adi-wayn/animatromic-head/docs/Animatronic Skull - 2456550/images/6c71d4edd238dc1699e310051e960971.png

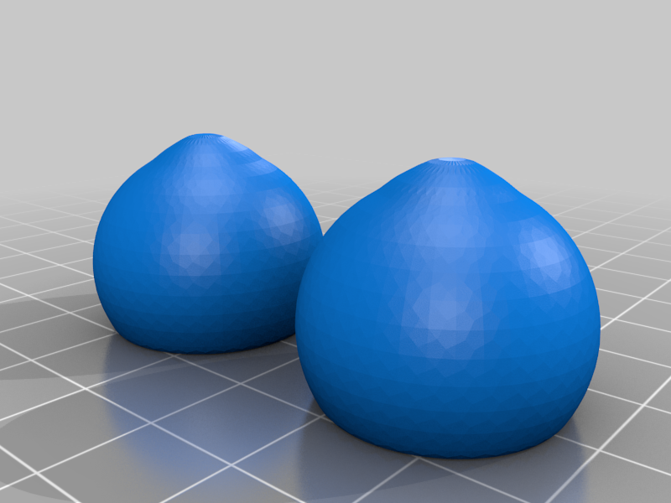
docs/Animatronic Skull - 2456550/images/6c71d4edd238dc1699e310051e960971.png
