adi-wayn/animatromic-head/docs/Animatronic Skull - 2456550/images/8e597aa7ed4feb77dbbf5bba94c87eed.png

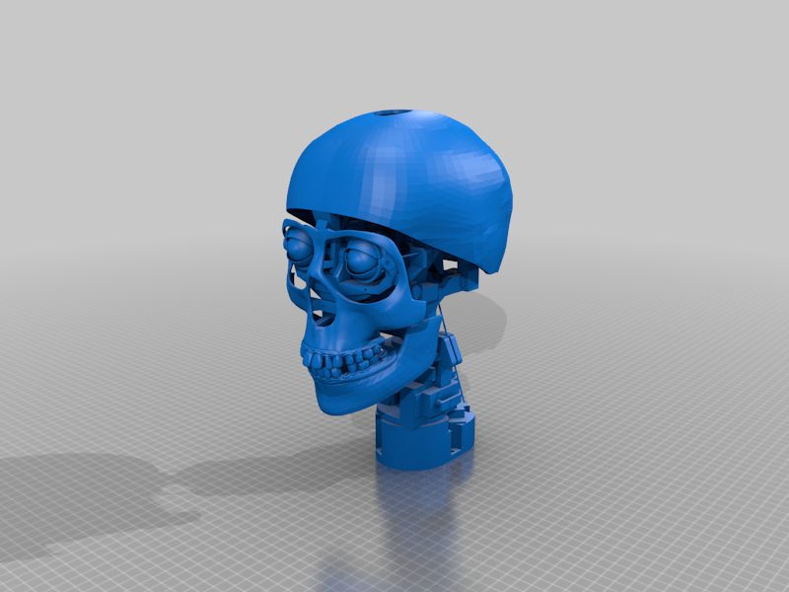
docs/Animatronic Skull - 2456550/images/8e597aa7ed4feb77dbbf5bba94c87eed.png
