adi-wayn/animatromic-head/docs/Animatronic Skull - 2456550/images/57f312213586f4db5ce062b65d8a6737.png

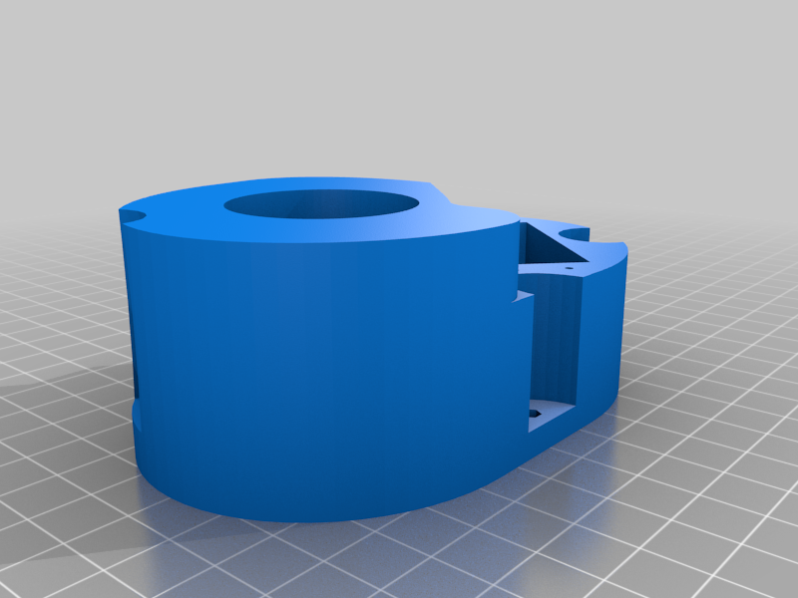
docs/Animatronic Skull - 2456550/images/57f312213586f4db5ce062b65d8a6737.png
