adi-wayn/animatromic-head/docs/Animatronic Skull - 2456550/images/98adeaafc3d5930cc63d995662715cfa.png

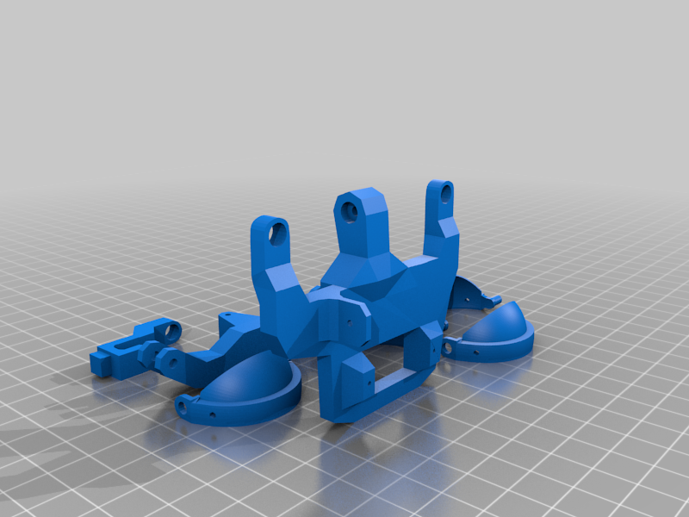
docs/Animatronic Skull - 2456550/images/98adeaafc3d5930cc63d995662715cfa.png
