adi-wayn/animatromic-head/docs/Animatronic Skull - 2456550/images/769c73fbf3607413a82ab738395b322f.png

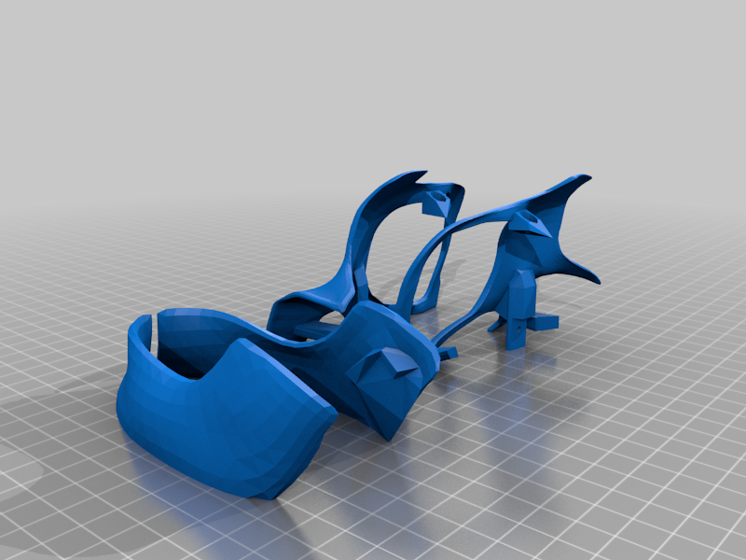
docs/Animatronic Skull - 2456550/images/769c73fbf3607413a82ab738395b322f.png
