adi-wayn/animatromic-head/docs/Animatronic Skull - 2456550/images/7205a307fcd111a9c5d29df97c076238.png

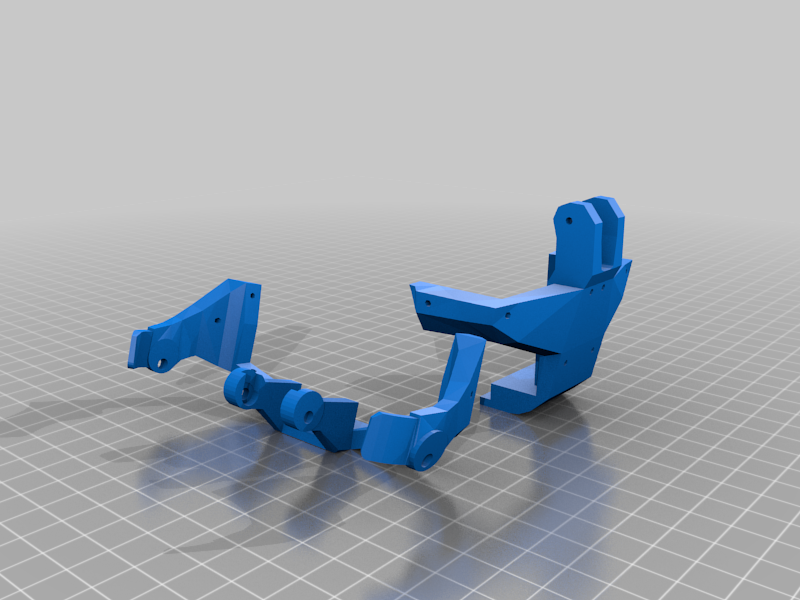
docs/Animatronic Skull - 2456550/images/7205a307fcd111a9c5d29df97c076238.png
