adi-wayn/animatromic-head/docs/Animatronic Skull - 2456550/images/20170731_230624.jpg

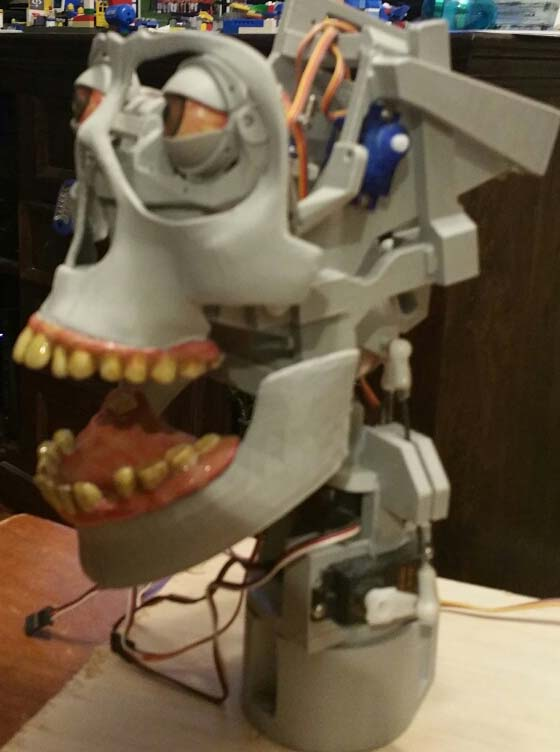
docs/Animatronic Skull - 2456550/images/20170731_230624.jpg
