adi-wayn/animatromic-head/docs/Animatronic Skull - 2456550/images/20170731_230637.jpg

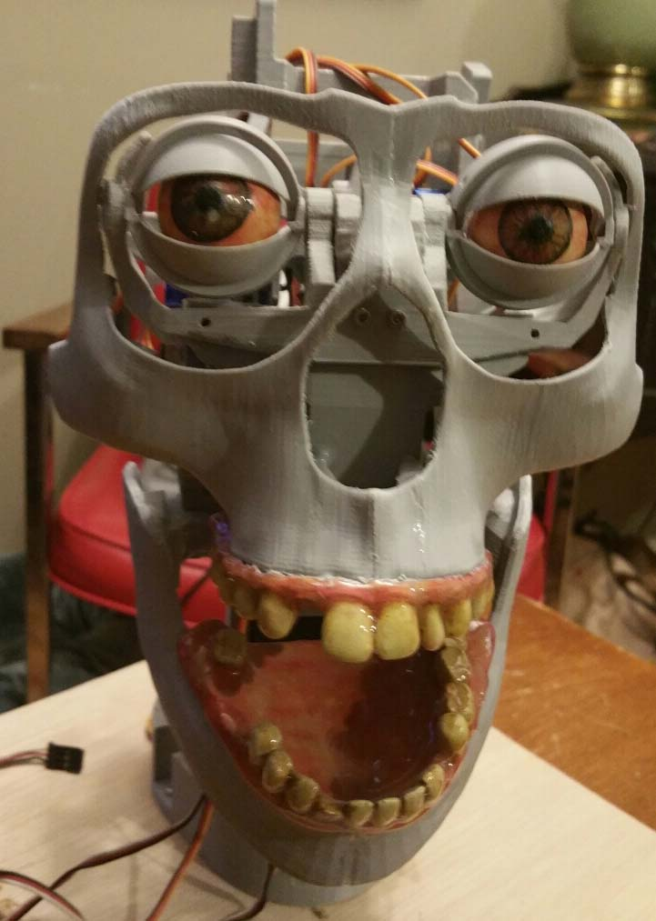
docs/Animatronic Skull - 2456550/images/20170731_230637.jpg
