adi-wayn/animatromic-head/docs/Animatronic Skull - 2456550/images/914772802240a5b13014ea125088135e.png

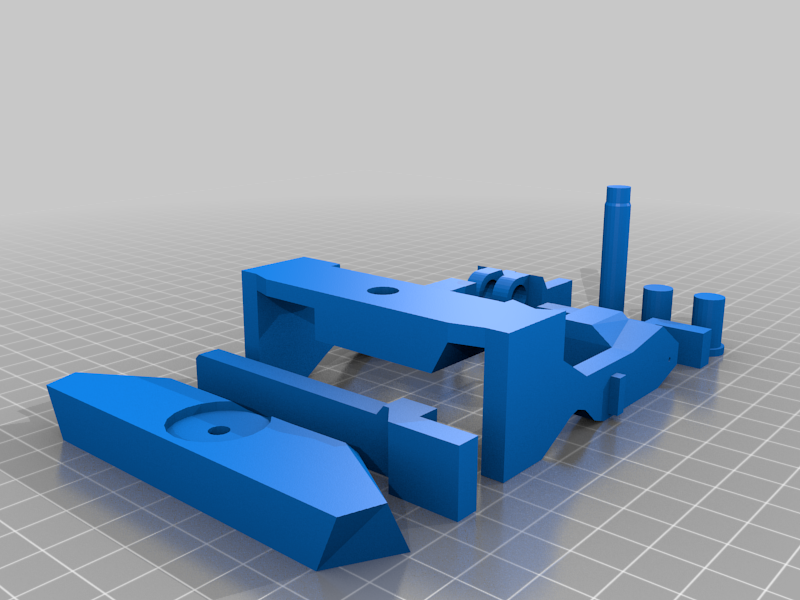
docs/Animatronic Skull - 2456550/images/914772802240a5b13014ea125088135e.png
