adi-wayn/animatromic-head/docs/Animatronic Skull - 2456550/images/a1fdf8aa04cd3241627027f55734ce39.png

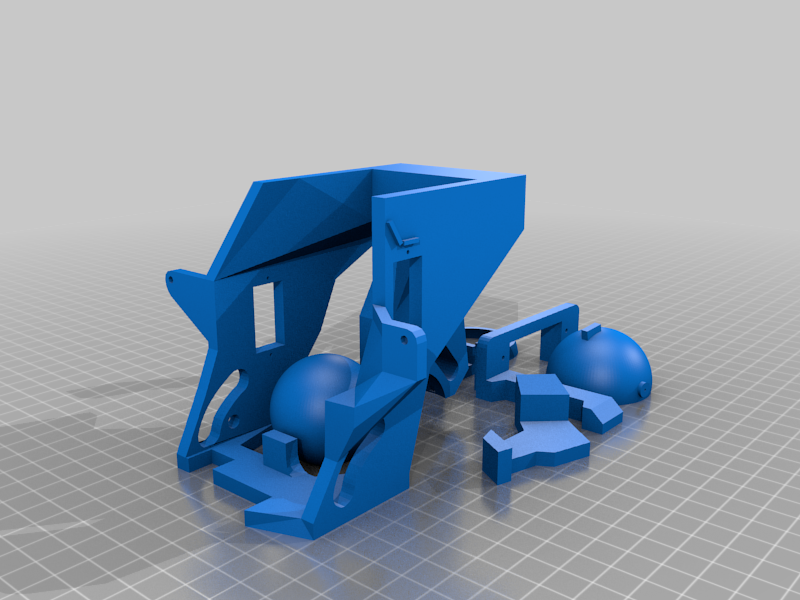
docs/Animatronic Skull - 2456550/images/a1fdf8aa04cd3241627027f55734ce39.png
