adi-wayn/animatromic-head/docs/Animatronic Skull - 2456550/images/a887fb557152063ed58c4bb3162da280.png

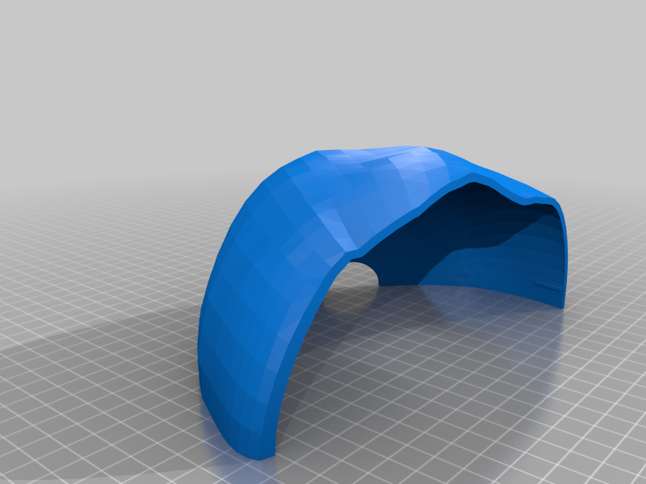
docs/Animatronic Skull - 2456550/images/a887fb557152063ed58c4bb3162da280.png
