adi-wayn/animatromic-head/docs/Animatronic Skull - 2456550/images/c83e7a57c6ebd02146b7218c535b35e5.png

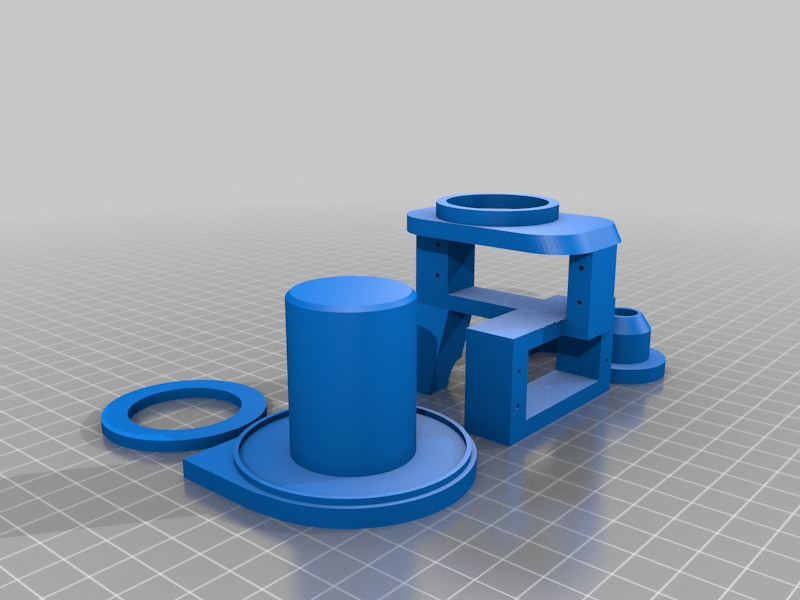
docs/Animatronic Skull - 2456550/images/c83e7a57c6ebd02146b7218c535b35e5.png
