adi-wayn/animatromic-head/docs/Animatronic Skull - 2456550/images/f0b370f981ca99bb3add569225a746b9.png

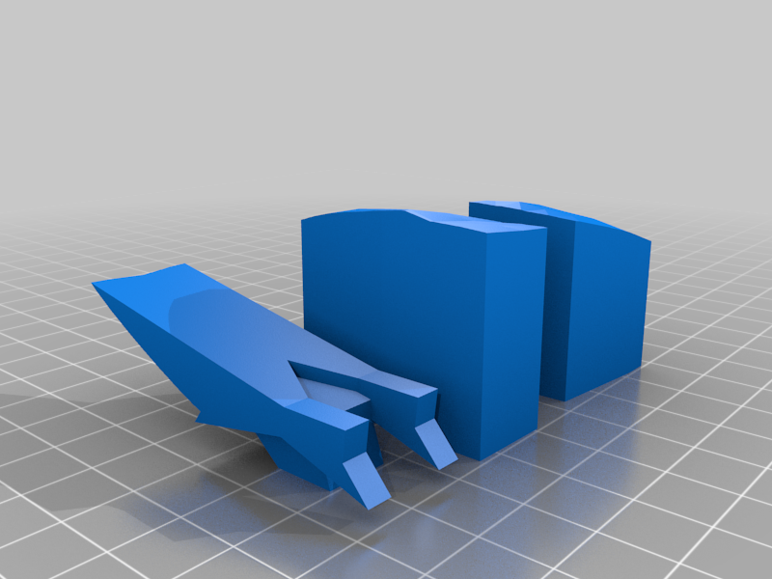
docs/Animatronic Skull - 2456550/images/f0b370f981ca99bb3add569225a746b9.png
