adi-wayn/animatromic-head/docs/Animatronic Skull - 2456550/images/f6bd3e2ded30b17894b5889a3ba40300.png

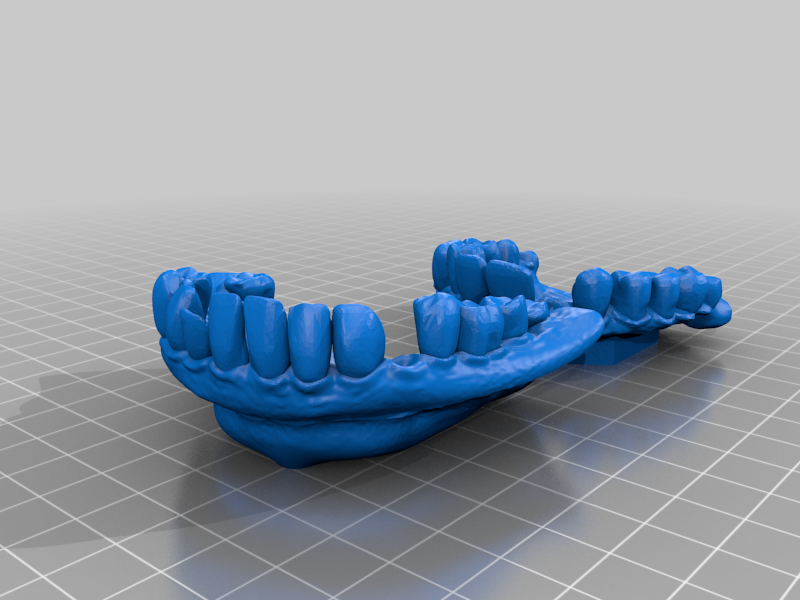
docs/Animatronic Skull - 2456550/images/f6bd3e2ded30b17894b5889a3ba40300.png
