adi-wayn/animatromic-head/docs/Animatronic Skull - 2456550/images/f53a53cf6e166b89eecce7e33b7ac451.png

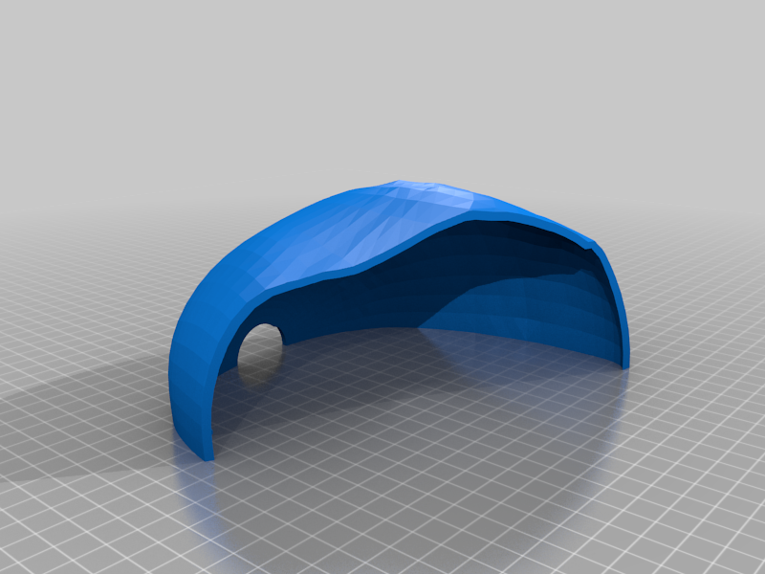
docs/Animatronic Skull - 2456550/images/f53a53cf6e166b89eecce7e33b7ac451.png
