adi-wayn/animatromic-head/host/simulator/screenshot.png

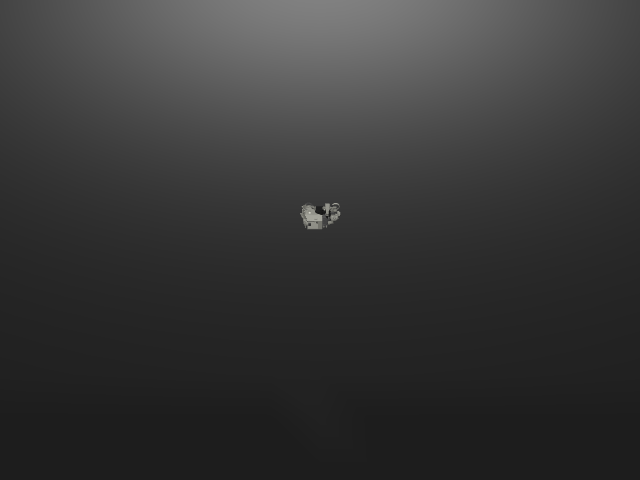
host/simulator/screenshot.png
