adi-wayn/animatromic-head/host/simulator/screenshot_0.png

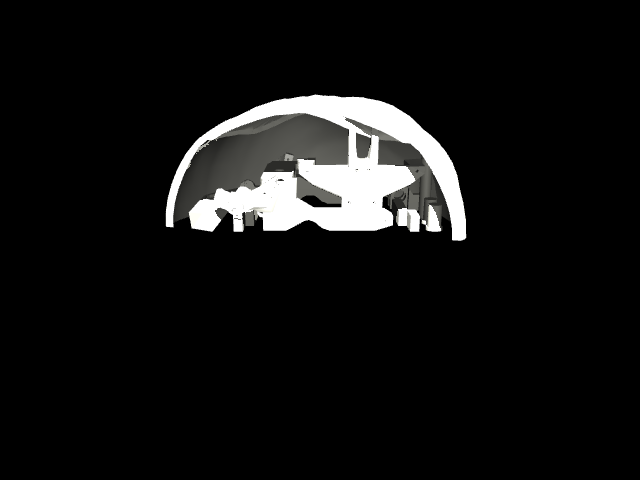
host/simulator/screenshot_0.png
