adi-wayn/animatromic-head/host/simulator/screenshot_1.png

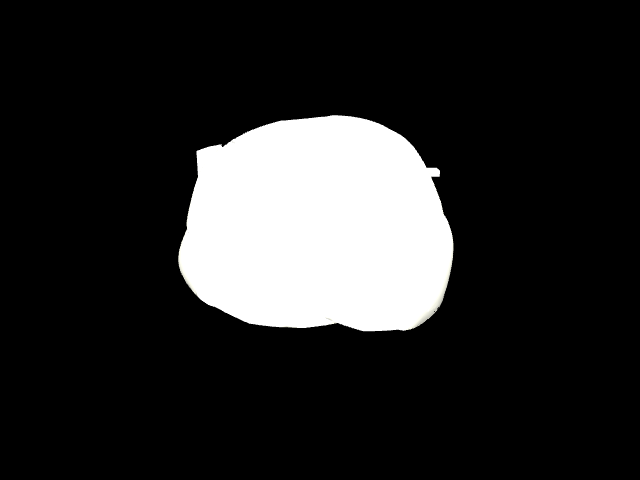
host/simulator/screenshot_1.png
