adi-wayn/animatromic-head/host/simulator/screenshot_2.png

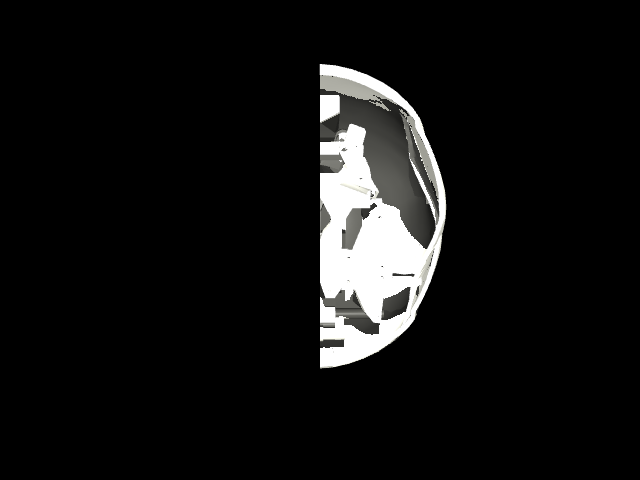
host/simulator/screenshot_2.png
