adi-wayn/animatromic-head/host/simulator/screenshot_3.png

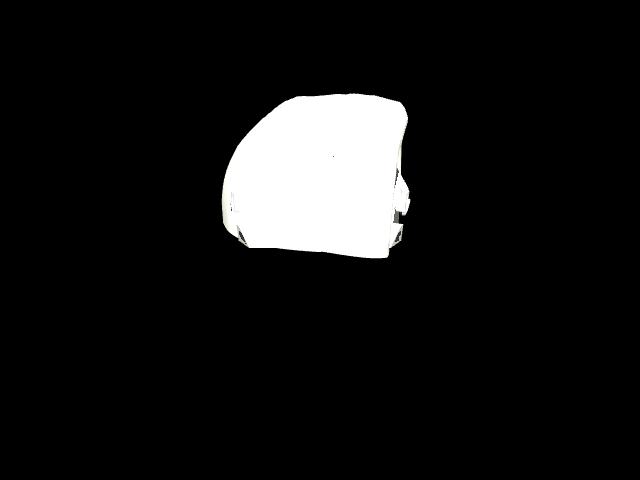
host/simulator/screenshot_3.png
