adi-wayn/animatromic-head/host/simulator/screenshot_4.png

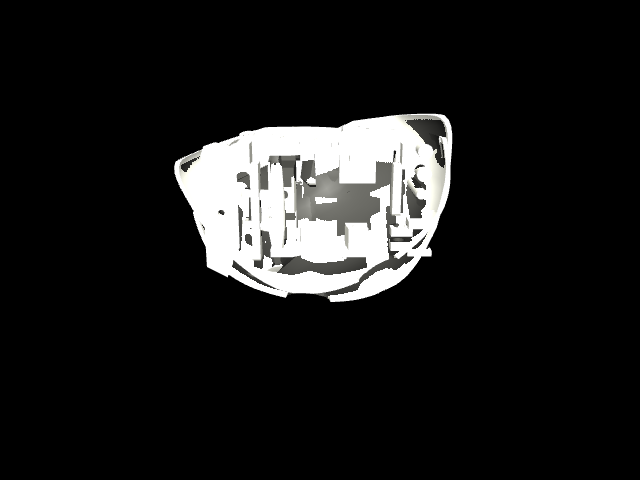
host/simulator/screenshot_4.png
