adi-wayn/animatromic-head/host/simulator/skull_screenshot.png

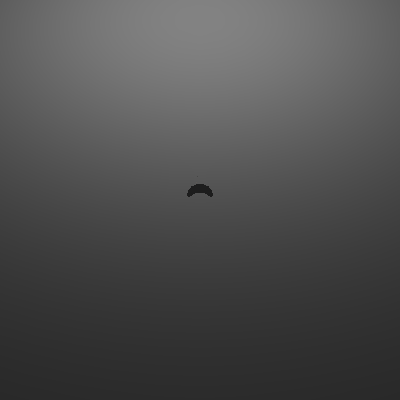
host/simulator/skull_screenshot.png
