adi-wayn/animatromic-head/docs/Animatronic Skull - 2456550/files/Main.stl

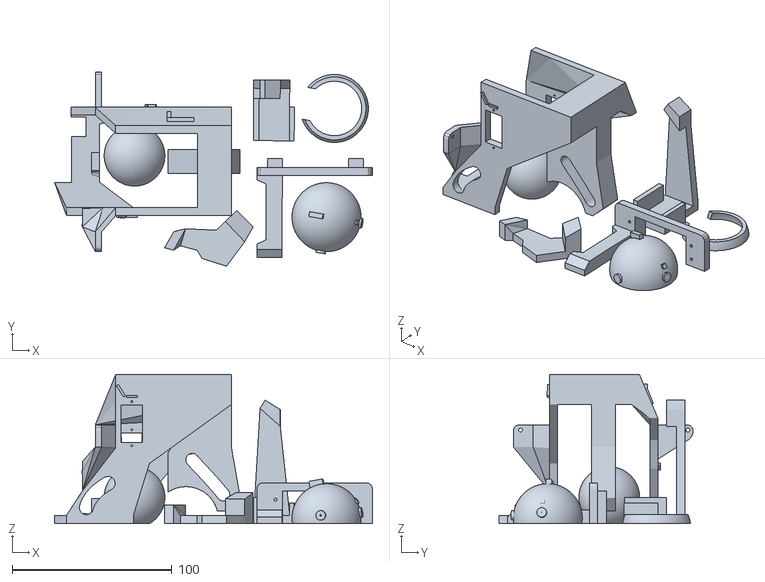
[picture p41: CAD file, 2026-07-02]
docs/Animatronic Skull - 2456550/files/Main.stl
199.1 x 121.7 x 93.4
