adi-wayn/animatromic-head/docs/Animatronic Skull - 2456550/files/RightSkull.stl

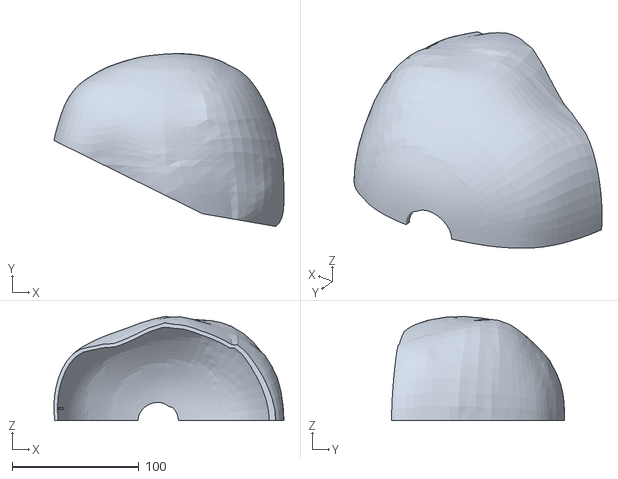
[picture p42: CAD file, 2026-07-02]
docs/Animatronic Skull - 2456550/files/RightSkull.stl
181.6 x 136.4 x 82.3
