adi-wayn/animatromic-head/host/simulator/upper_skull.obj

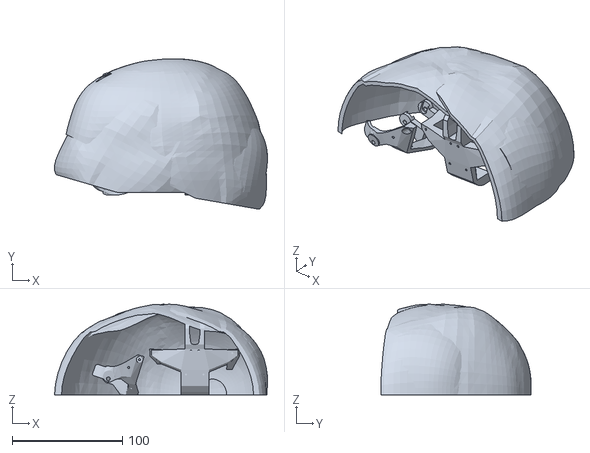
[picture p43: CAD file, 2026-07-27]
host/simulator/upper_skull.obj
193.1 x 136.4 x 82.3
