adi-wayn/animatromic-head/host/simulator/beautiful_lower_jaw.obj

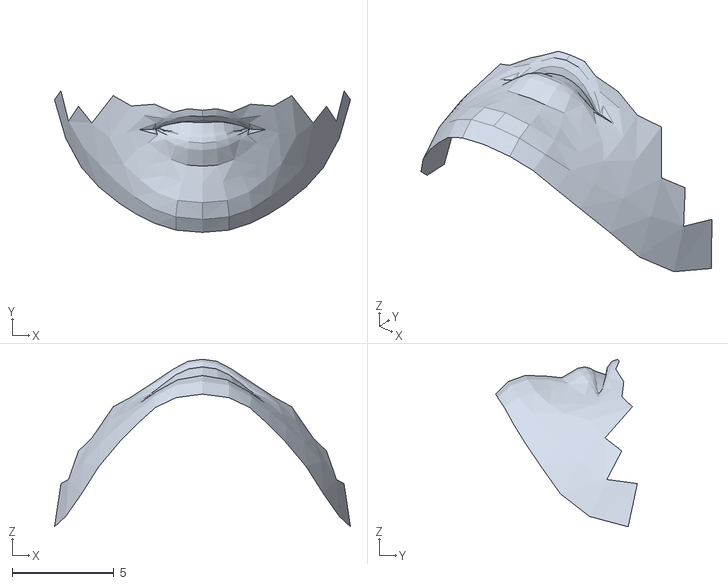
[picture p44: CAD file, 2026-07-27]
host/simulator/beautiful_lower_jaw.obj
14.5 x 6.96 x 8.23
