adi-wayn/animatromic-head/docs/Animatronic Skull - 2456550/files/LeftSkull.stl

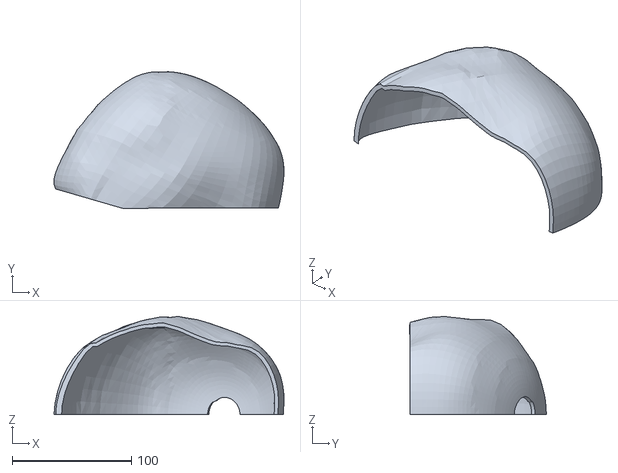
[picture p45: CAD file, 2026-07-02]
docs/Animatronic Skull - 2456550/files/LeftSkull.stl
193.1 x 114.8 x 82.3
