adi-wayn/animatromic-head/host/simulator/beautiful_upper_face.obj

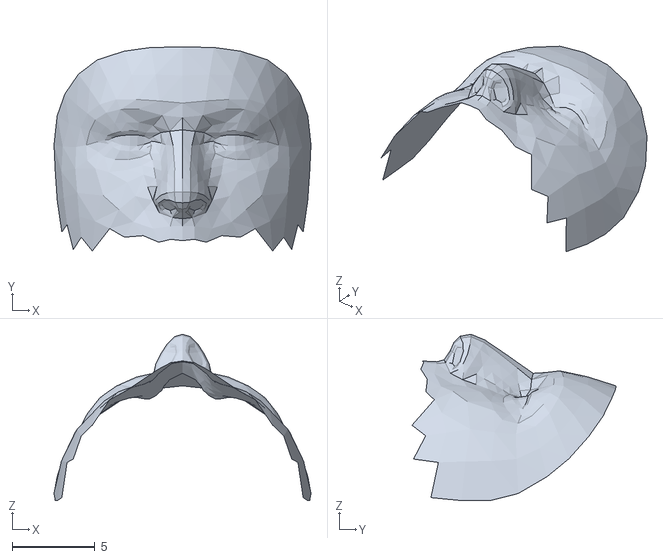
[picture p46: CAD file, 2026-07-27]
host/simulator/beautiful_upper_face.obj
15.5 x 12.3 x 10.0
