adi-wayn/animatromic-head/docs/Animatronic Skull - 2456550/files/teeth.stl

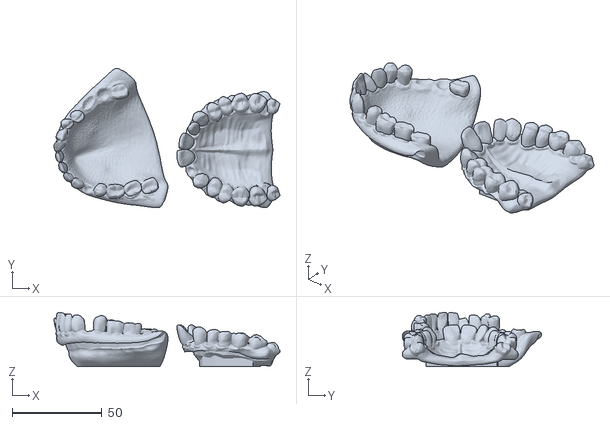
[picture p47: CAD file, 2026-07-02]
docs/Animatronic Skull - 2456550/files/teeth.stl
125.6 x 77.5 x 30.0
