adi-wayn/animatromic-head/host/simulator/skull.obj

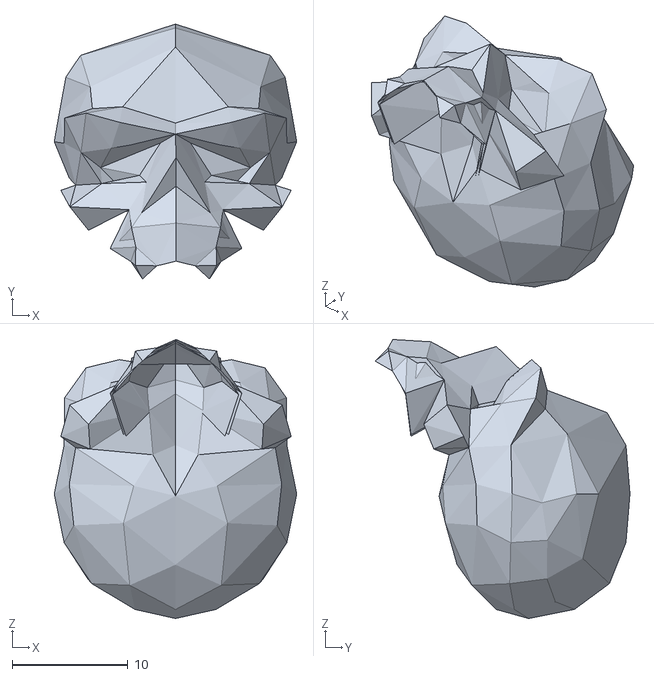
[picture p48: CAD file, 2026-07-27]
host/simulator/skull.obj
20.9 x 22.0 x 24.1
