adi-wayn/animatromic-head/docs/Animatronic Skull - 2456550/files/face.stl

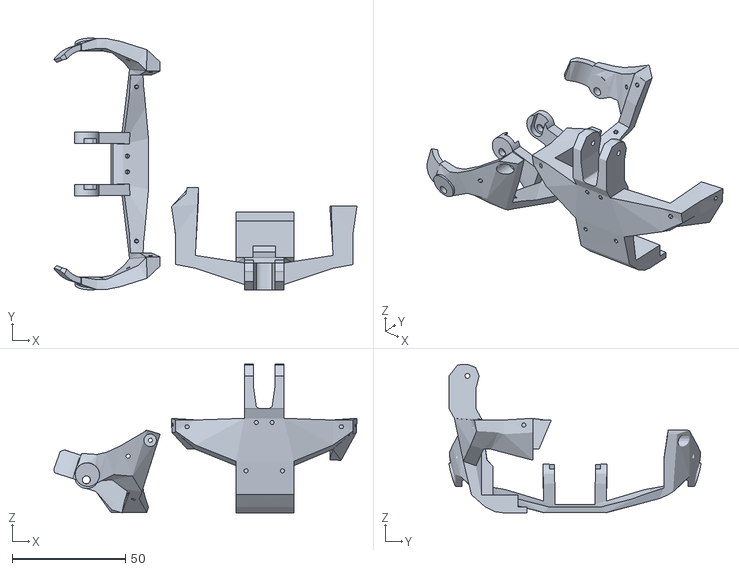
[picture p49: CAD file, 2026-07-02]
docs/Animatronic Skull - 2456550/files/face.stl
133.6 x 111.0 x 65.5
