adi-wayn/animatromic-head/host/simulator/canonical_face_model.obj

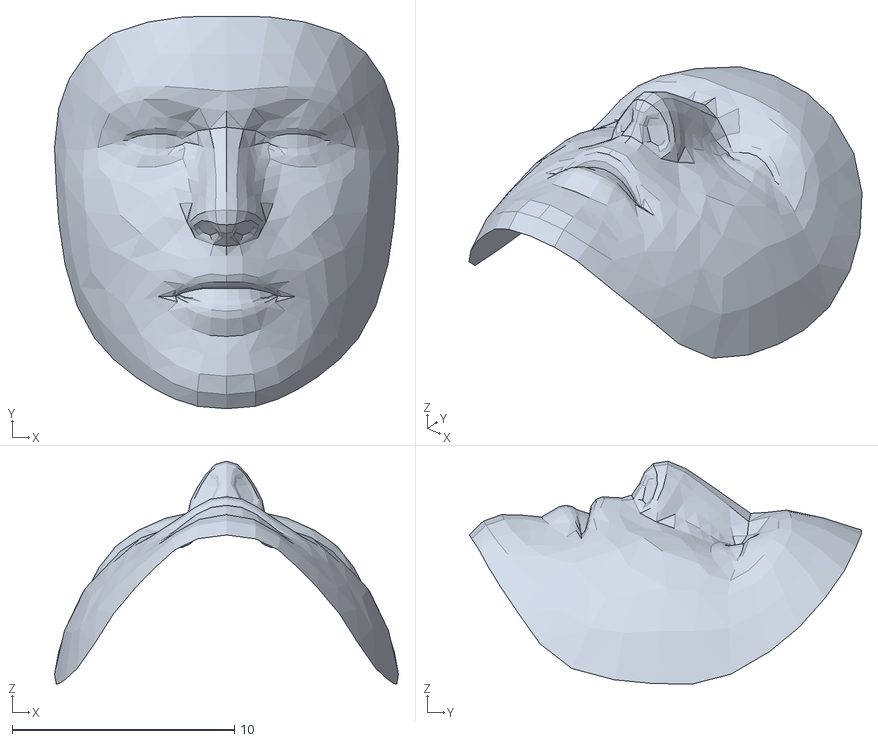
[picture p50: CAD file, 2026-07-27]
host/simulator/canonical_face_model.obj
15.5 x 17.7 x 10.0
