adi-wayn/animatromic-head/docs/Animatronic Skull - 2456550/files/eyeballs.stl

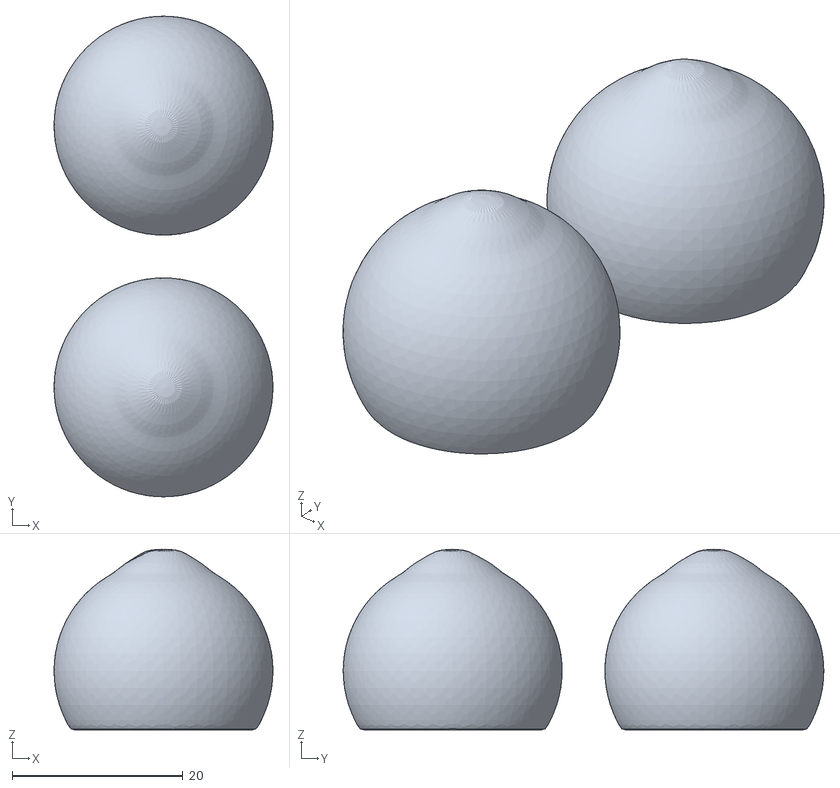
[picture p51: CAD file, 2026-07-02]
docs/Animatronic Skull - 2456550/files/eyeballs.stl
25.6 x 56.3 x 21.1
