adi-wayn/animatromic-head/docs/Animatronic Skull - 2456550/files/skullparts.stl

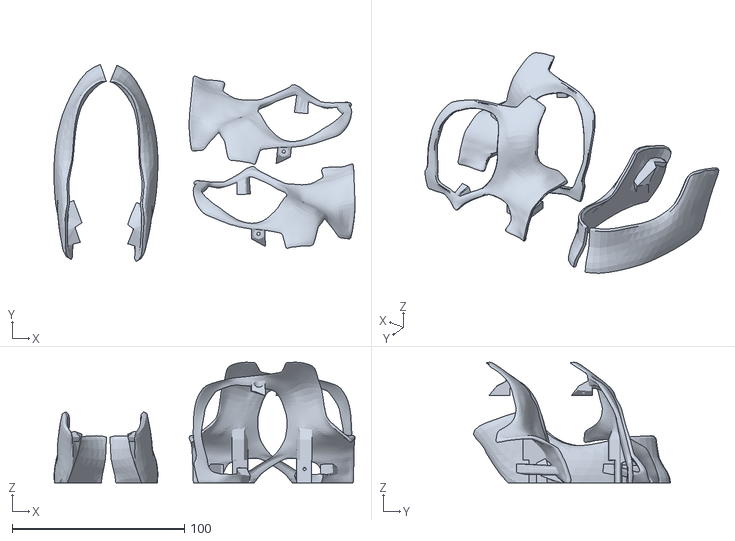
[picture p52: CAD file, 2026-07-02]
docs/Animatronic Skull - 2456550/files/skullparts.stl
175.0 x 114.6 x 70.2
