adi-wayn/animatromic-head/docs/Animatronic Skull - 2456550/files/eyemech.stl

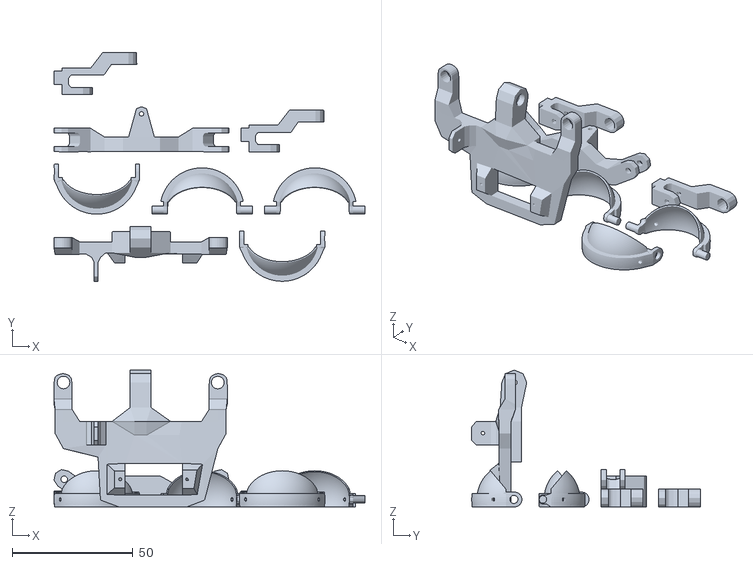
[picture p53: CAD file, 2026-07-02]
docs/Animatronic Skull - 2456550/files/eyemech.stl
128.5 x 94.5 x 56.6
