adi-wayn/animatromic-head/docs/Animatronic Skull - 2456550/files/Neck.stl

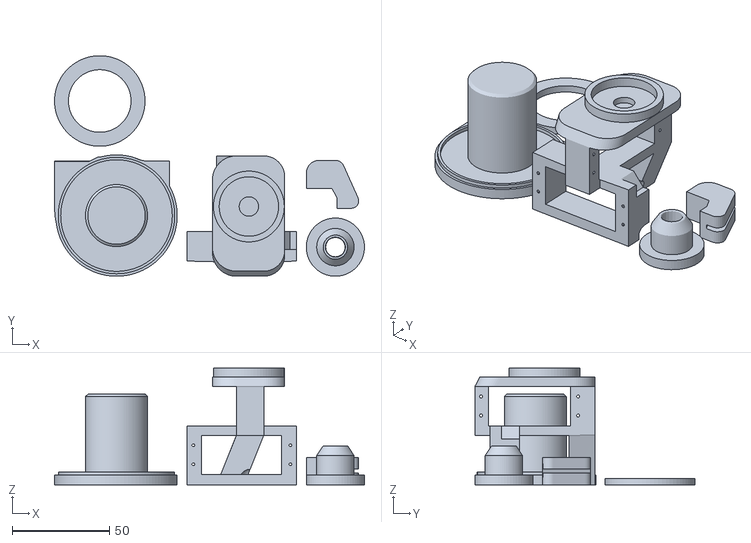
[picture p54: CAD file, 2026-07-02]
docs/Animatronic Skull - 2456550/files/Neck.stl
159.7 x 113.6 x 60.1
