adi-wayn/animatromic-head/docs/Animatronic Skull - 2456550/files/skullcapMounts.stl

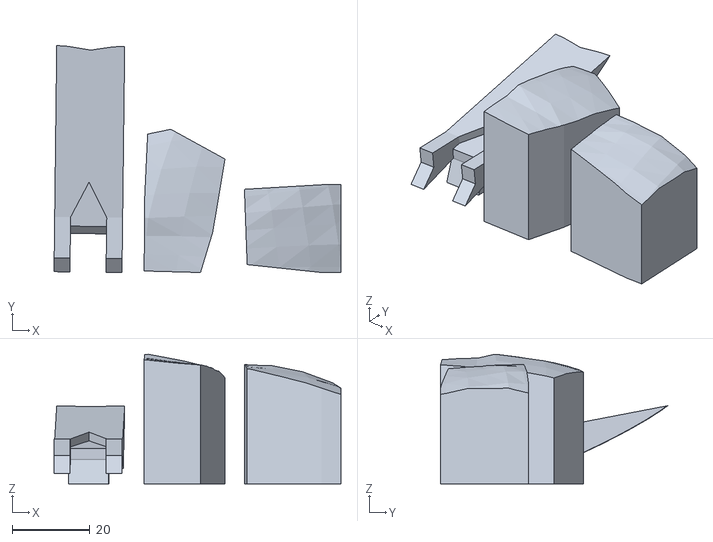
[picture p55: CAD file, 2026-07-02]
docs/Animatronic Skull - 2456550/files/skullcapMounts.stl
73.8 x 58.4 x 33.3
