adi-wayn/animatromic-head/docs/Animatronic Skull - 2456550/files/base.stl

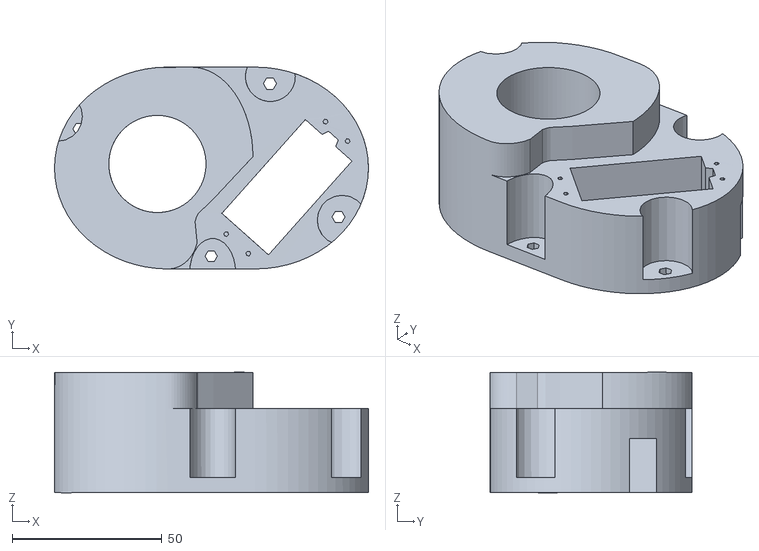
[picture p56: CAD file, 2026-07-02]
docs/Animatronic Skull - 2456550/files/base.stl
104.7 x 67.3 x 40.2
