adi-wayn/animatromic-head/docs/Animatronic Skull - 2456550/files/jaw.stl

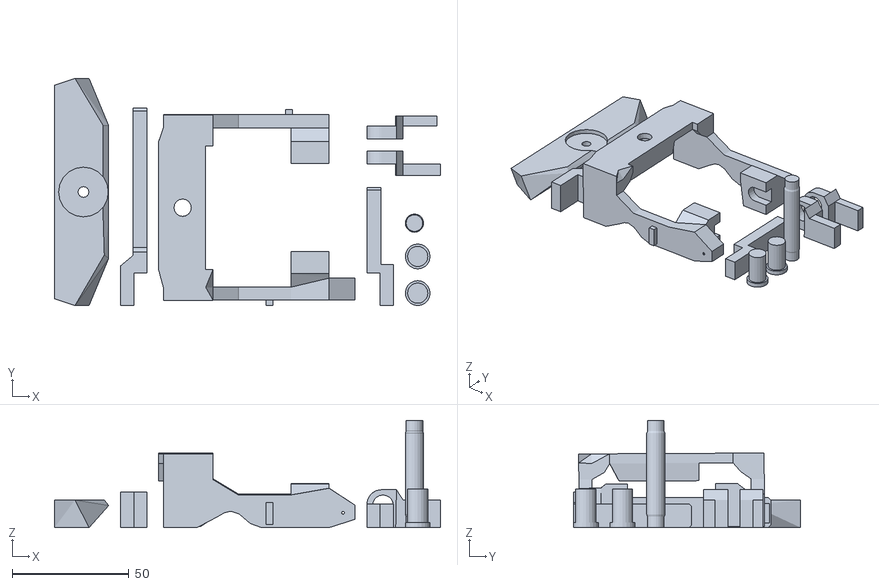
[picture p57: CAD file, 2026-07-02]
docs/Animatronic Skull - 2456550/files/jaw.stl
165.3 x 97.3 x 45.9
