adi-wayn/animatromic-head/host/debug/audio_analysis.png

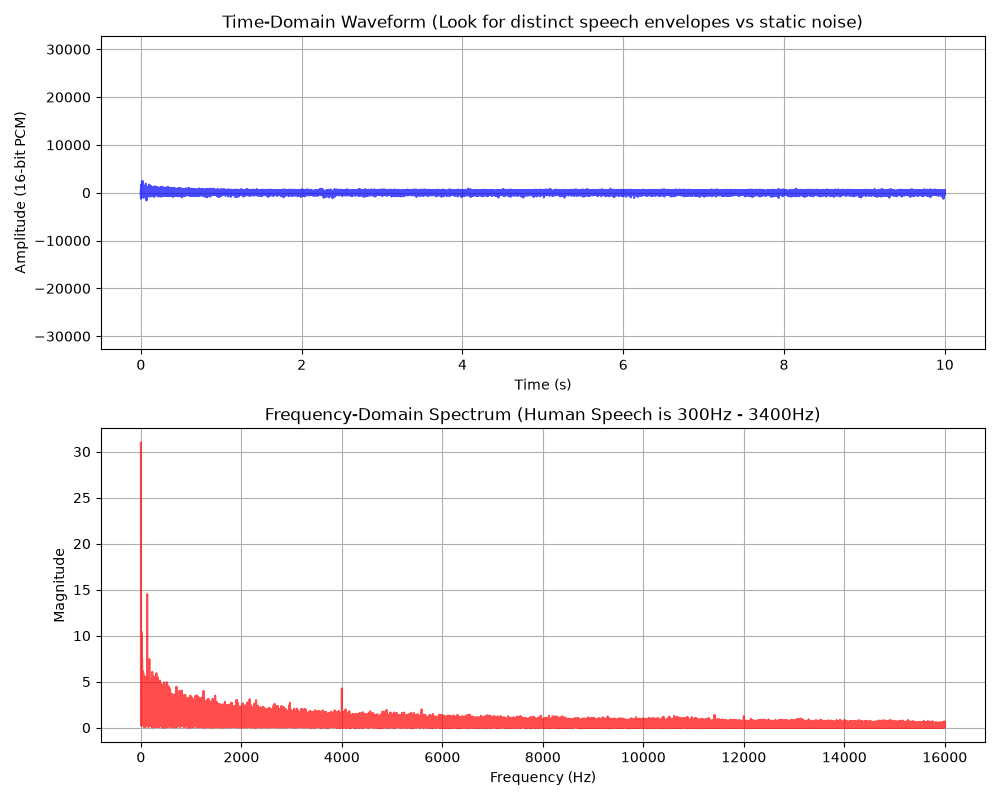
host/debug/audio_analysis.png
