adi-wayn/animatromic-head/(commit log)

2026-07-20 Refactor Animatronic Head Code Structure and Enhance Functionality
    - Updated include paths in c_cpp_properties.json and launch.json to reflect new project structure.
    - Removed eyelids task implementation and header files as they are no longer needed.
    - Introduced AnimatronicHead class to encapsulate head movement logic and improve code organization.
    - Added methods for basic movements (look left/right/up/down, tilt) and eyelid control (blink).
    - Implemented smooth movement for servos to enhance realism.
    - Added initialization flag for PCA9685 driver to prevent movement before setup.
    - Updated main loop to handle CLI commands for controlling the animatronic head.
    - Adjusted channel assignment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
    [AnimatronicHead.h, driver.cpp, driver.h, main.cpp]
2026-07-20 Refactor animatronic head control structure
    - Removed individual eyelid, eye, jaw, and neck control files to streamline the codebase.
    - Introduced AnimatronicHead class to encapsulate all head movements and expressions.
    - Centralized servo configurations in Config.h for easier adjustments.
    - Implemented smooth and saccade movement functions for more natural animations.
    - Added idle mode functionality with micro-movements for realism.
    - Enhanced safety mechanisms in PCA9685 driver for thread-safe operations.
    - Updated main loop to support new idle micro-movements.
2026-07-21 Add Implementation Roadmap, Software Design Document, and Software Requirements Specification
    - Created Implementation_Roadmap.md to outline the step-by-step implementation strategy for the Animatronic Head Platform.
    - Added AnimatronicHead_SDD.md detailing the software design architecture and components for the LLM-Powered Animatronic Head.
    - Introduced AnimatronicHead_SRS.md defining operational capabilities, hardware integrations, and behavioral logic for the platform.
    - Updated .DS_Store files in root and docs directories.
2026-07-21 feat: Implement Task 1.1 and 1.3 (Non-blocking kinematics & staggered boot)
2026-07-23 feat(protocol): implement 3-port UDP topology and TTS_COMPLETE message
    - Extend schema.json with ports and audio_format sections.
    - Add TTS_COMPLETE to message types.
    - Update generate_protocol.py to emit port and audio constants for C++ and Python.
    - Fix generate_protocol.py path resolution for PlatformIO SCons context.
    - Migrate NetworkManager.h and esp32_adapter.py to use auto-generated port constants.
    - Fix esp32_adapter.py create_phase_message bug.
2026-07-25 feat(audio): implement edge audio downlink — TTS to MAX98357A speaker (Task 4.2)
    - AudioManager: add beginSpeaker(), receiveFromHost(), writeToSpeaker(), flushSpeaker()
    - SystemTasks: add audioDownlinkTask (Core 0, P20)
    - ProtocolDispatcher: add TTS_COMPLETE handler → IDLE_LISTENING
    - DualTTSManager: replace pyaudio with UDP streaming + scipy resampling
    - esp32_adapter: fix duplicate ESP32_IP bug, fix logger ordering
    - test_speaker_stream.py: standalone WAV streaming test script
    [AudioManager.cpp, ProtocolDispatcher.cpp, SystemTasks.cpp, main.cpp]
2026-07-25 feat(audio): real-time lip sync & VAD interruption (Task 4.3)
    - Edge: audioDownlinkTask calculates RMS amplitude of incoming PCM
    - Edge: PoseController adds syncJawToAmplitude to drive jaw directly from RMS
    - Edge: kinematicsTask updates jaw at 60Hz during SPEAKING_SYNCING phase
    - Edge: ProtocolDispatcher instantly flushes audio DMA and closes jaw on EMERGENCY_STOP
    - Removes network latency from lip-sync pipeline
2026-07-26 feat: complete Phase 2 protocol reliability (jitter buffer, telemetry, ip latching)
    [AudioManager.cpp, NetworkManager.cpp, SystemTasks.cpp, main.cpp]
2026-07-27 Fix interrupt logic, implement word-level streaming for ultra-low latency, and add noise floor for jaw lip-sync
2026-07-27 Add animatronic skull model and related assets
    - Created a new MuJoCo XML model for an animatronic skull, including upper face and lower jaw meshes.
    - Added a Python script to split a canonical face model into upper and lower parts, generating corresponding OBJ files.
    - Implemented a screenshot capture script for the skull model using MuJoCo, allowing for rendering from different angles.
    - Included a placeholder for a screenshot image of the skull model.
    [beautiful_lower_jaw.obj, beautiful_upper_face.obj, canonical_face_model.obj, skull.obj, upper_skull.obj]
2026-08-23 Add unit test for VADManager speech detection functionality
    - Implemented a new test case in _archived_test_vad.py to validate the speech detection logic of the VADManager.
    - Mocked dependencies including the Silero model and dual_tts_manager to isolate the test environment.
    - Verified that speech is detected correctly and that silence is handled as expected, ensuring proper interaction with the audio callback.
    [AnimatronicHead.h, AudioManager.cpp, Config.h, I2SAudioConfig.h, NetworkManager.cpp, PoseController.cpp]
2026-08-23 feat: add expressAngry and expressSurprised methods to PoseController; update servo configurations for improved range
2026-08-24 feat: setup INMP441 hardware DSP config and fallback to Mac mic
    This PR applies the bulletproof 32-bit DSP configuration for the INMP441 microphone (resolving the 1024 DMA buffer overflow limit and applying a 32000Hz sampling rate to prevent PLL clock failure). Due to a confirmed physical hardware failure with the INMP441 MEMS sensor on the breadboard, the host orchestrator has been configured to use the Mac's built-in microphone for now.
    [AudioManager.cpp, Config.h, I2SAudioConfig.h, SystemTasks.cpp]
2026-08-24 Add offline TTS test script for XTTSStrategy
    - Introduced a new test script `test_offline_tts.py` to validate the functionality of the XTTSStrategy.
    - The script synthesizes speech from a given text and saves the output as a WAV file.
    - Includes error handling for audio byte generation and confirms successful file saving.
    [Config.h, PoseController.cpp]
2026-08-25 feat: integrate HC-SR05 ultrasonic sensor and radar scanning functionality
2026-08-30 Replace iframe schematic with embedded screenshot + link for iPad offline support
    - Replace Cirkit Designer iframe with embedded PNG screenshot of the schematic
    - Add clickable link to open interactive schematic in browser (works on iPad)
    - Add new gallery photos (IMG_7335, IMG_7284)
    - Presentation now works fully offline in Documents by Readdle on iPad
2026-09-04 chore: organize repo for publication
    - Delete private photos (IMG_6564, IMG_6581, IMG_6582) and duplicate photos
    - Delete personal voice recording (debug_user_input.wav)
    - Move debug artifacts to host/debug/
    - Move utility scripts to host/scripts/
    - Move voice reference files to host/assets/
    - Move test_mic_offline.cpp.bak to edge/test_mic_standalone/
    - Remove Piper binaries (host/bin/) from tracking
    - Remove ESP32 Course Material from tracking
    - Remove .remember/, .pytest_cache/ from tracking
    - Update .gitignore comprehensively
2026-09-04 style: professionalize codebase, add documentation, formatting and license
    - Add MIT LICENSE file
    - Add root .clang-format and reformat all C/C++ files
    - Format and lint all Python files with Ruff
    - Add Google-style docstrings and clean up tutorial-like comments across Edge and Host
    - Add auto-generated notice to protocol bindings
    - Remove private images from presentation.html
    - Rewrite README.md with badges, table of contents, diagrams, and project details
    [AnimatronicHead.h, AudioManager.cpp, Config.h, I2SAudioConfig.h]
