adi-wayn/animatromic-head/docs/photos/image.png

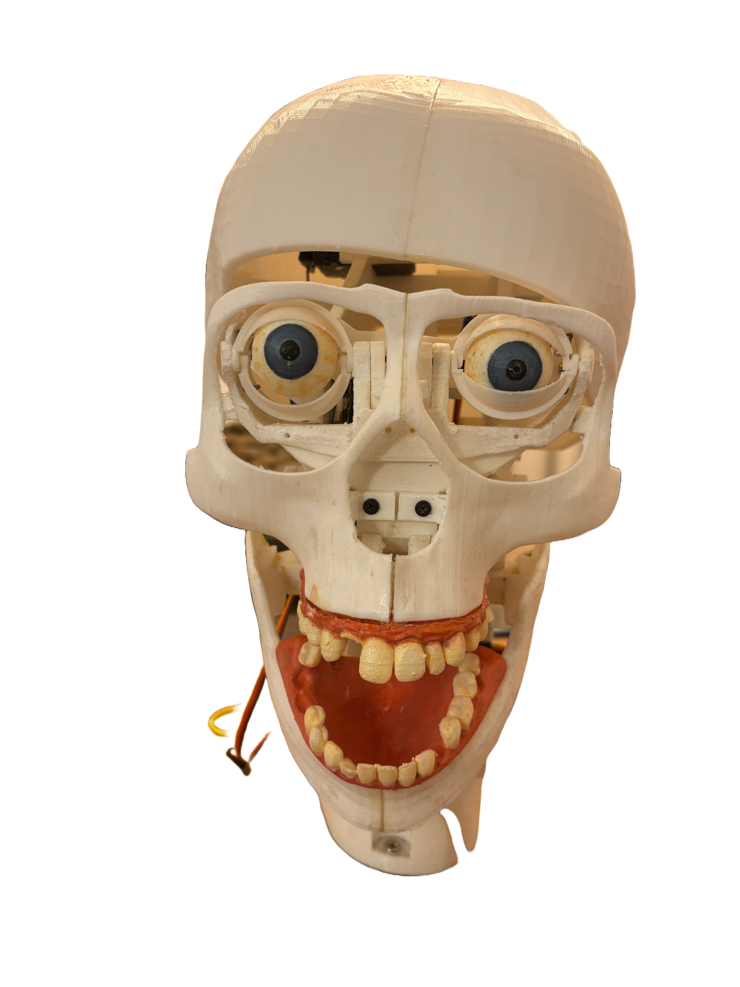
docs/photos/image.png
