adi-wayn/animatromic-head/docs/photos/IMG_6118.jpeg

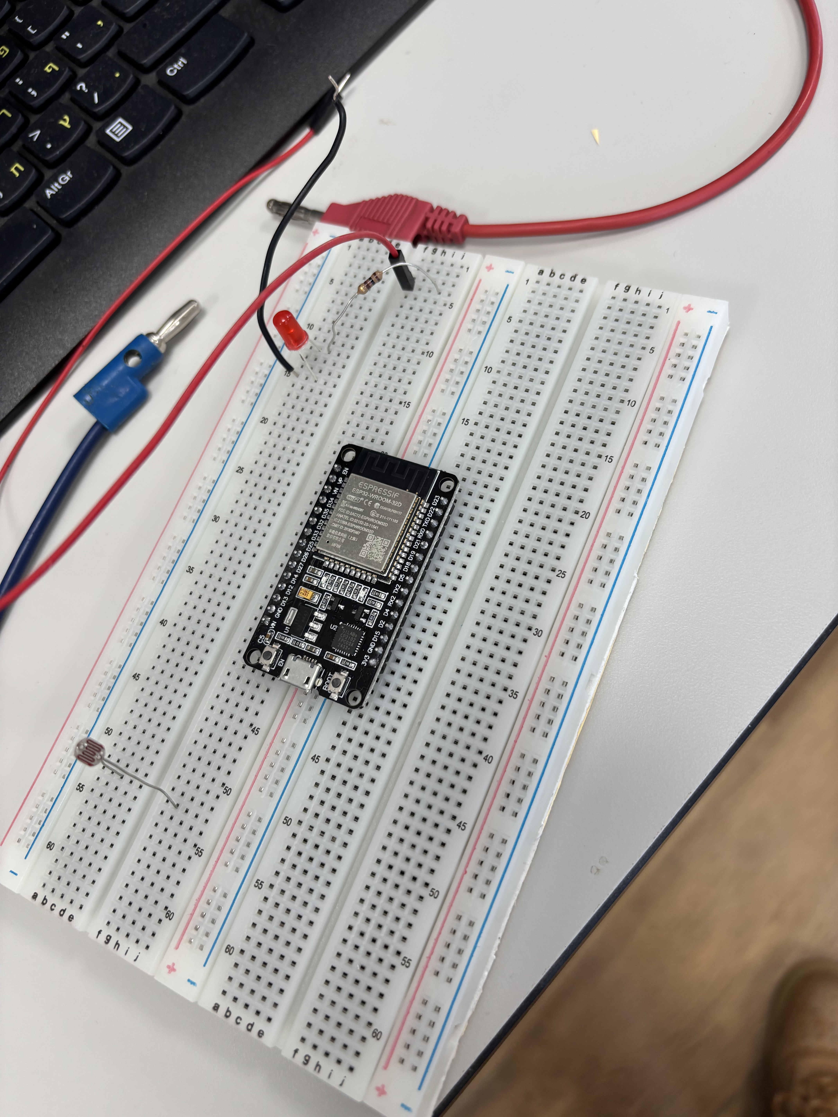
docs/photos/IMG_6118.jpeg
