adi-wayn/animatromic-head/docs/photos/IMG_7284.jpeg

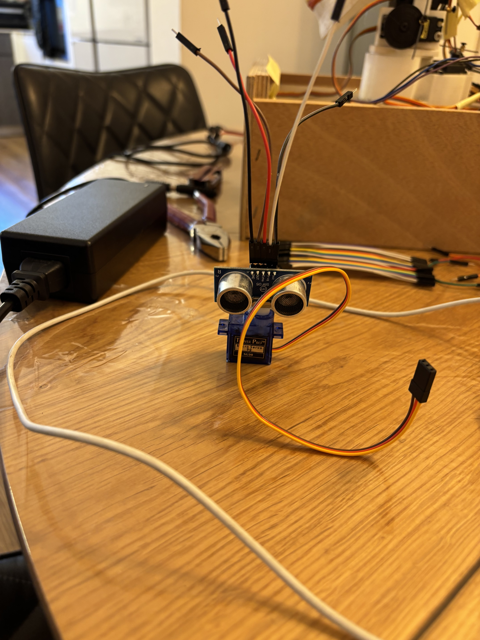
docs/photos/IMG_7284.jpeg
