adi-wayn/animatromic-head/docs/photos/IMG_7297.jpeg

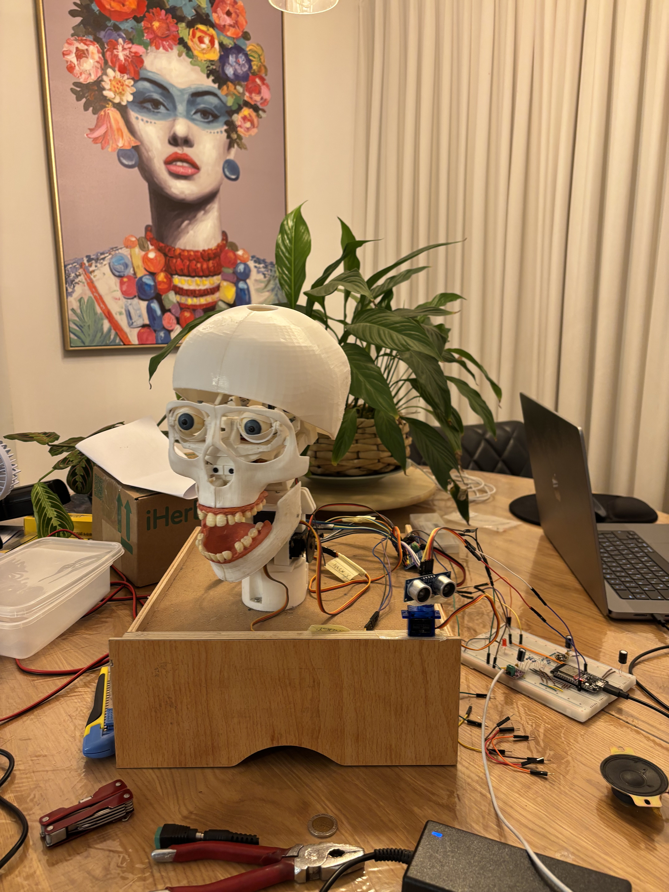
docs/photos/IMG_7297.jpeg
