adi-wayn/animatromic-head/docs/photos/IMG_7298.jpeg

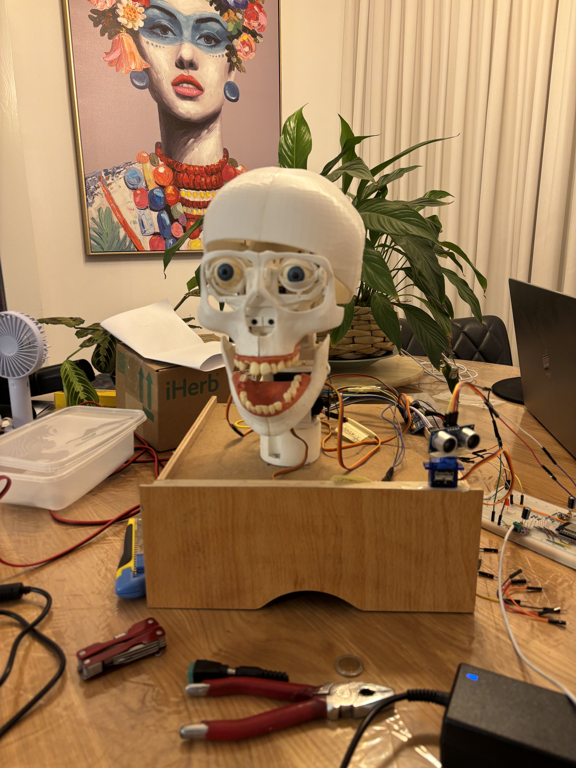
docs/photos/IMG_7298.jpeg
