adi-wayn/animatromic-head/docs/photos/IMG_7299.jpeg

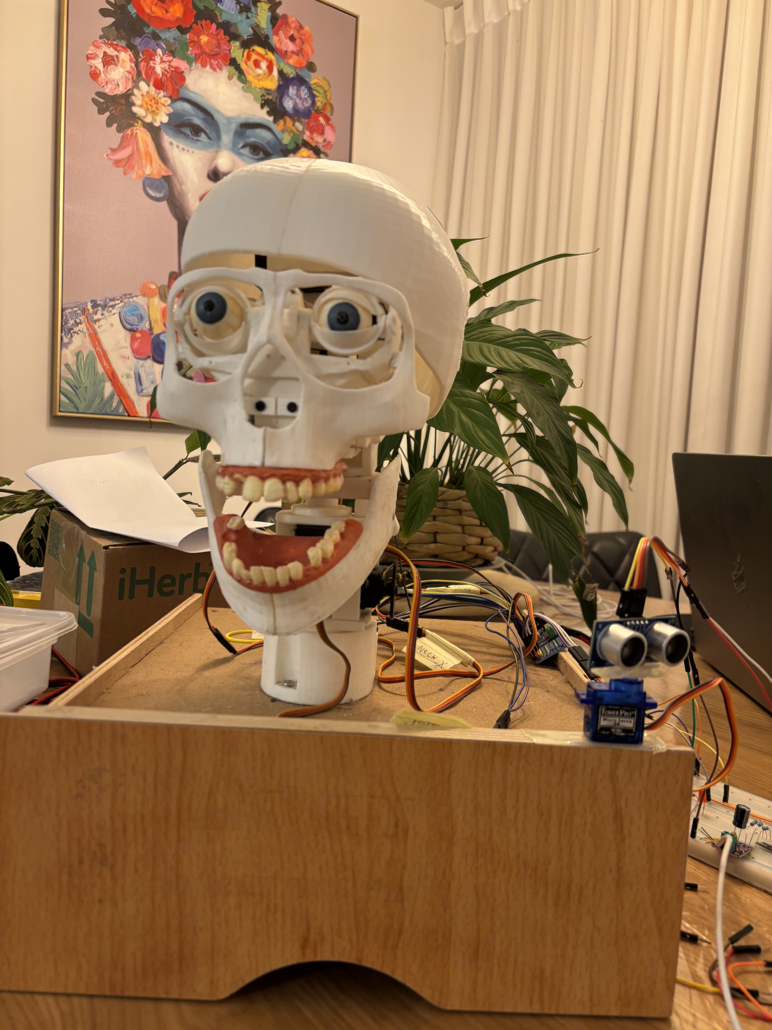
docs/photos/IMG_7299.jpeg
