adi-wayn/animatromic-head/docs/photos/IMG_7300.jpeg

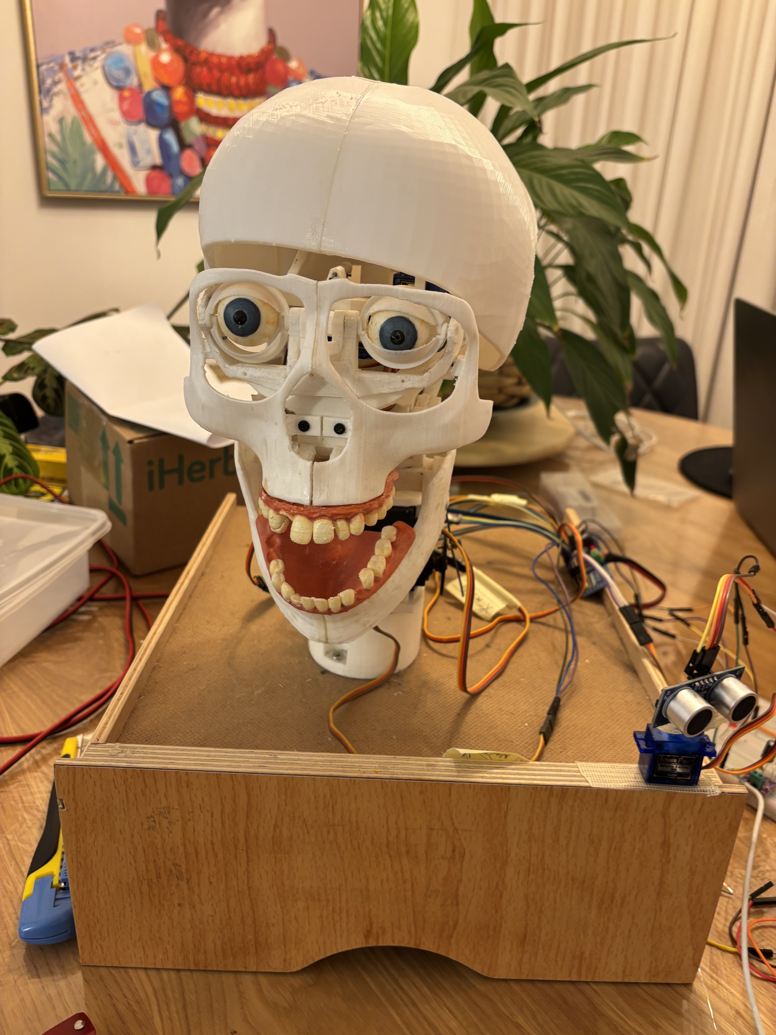
docs/photos/IMG_7300.jpeg
