adi-wayn/animatromic-head/docs/photos/IMG_7301.jpeg

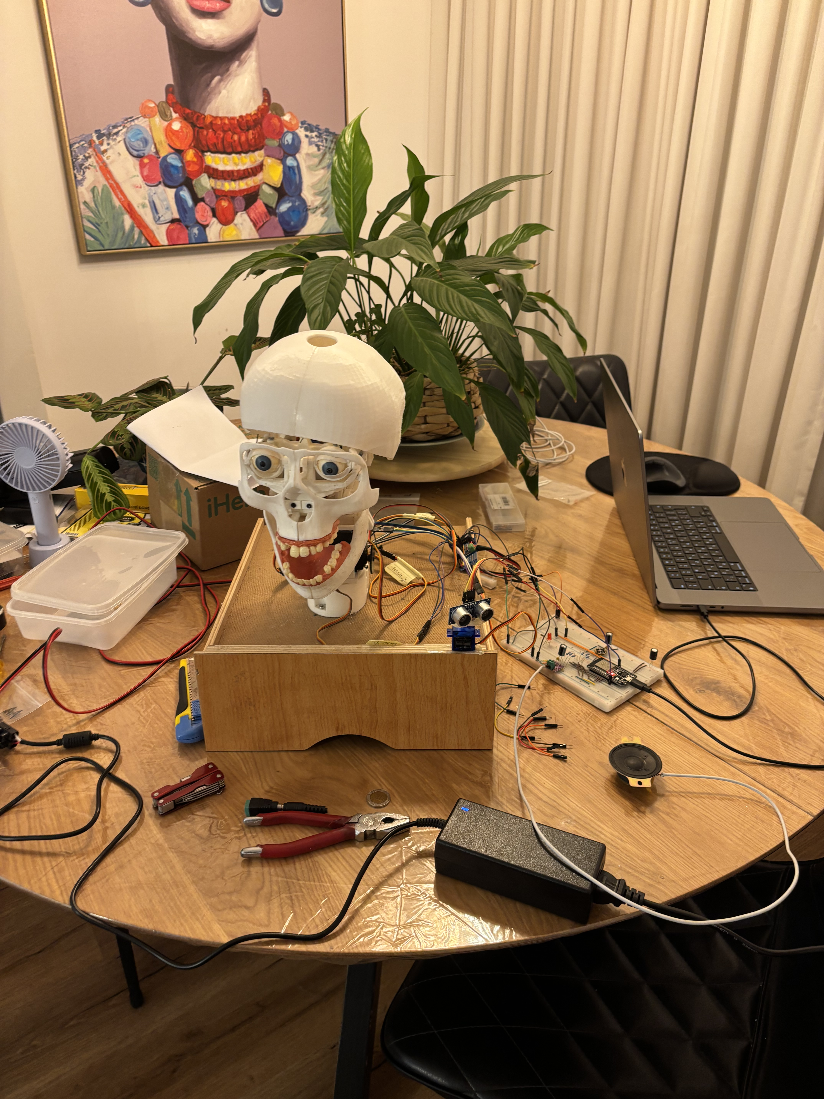
docs/photos/IMG_7301.jpeg
