adi-wayn/animatromic-head/docs/photos/IMG_7335.jpeg

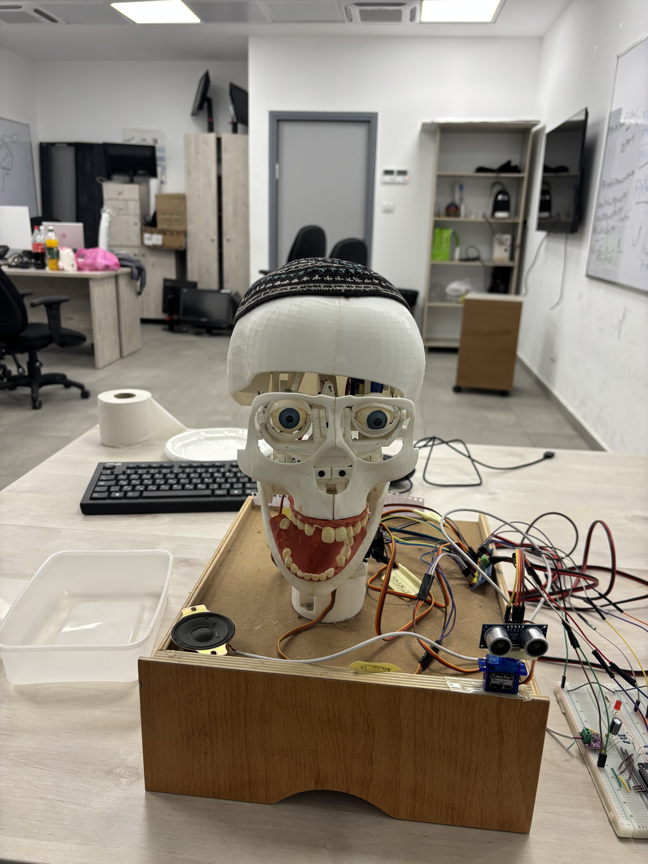
[picture p1: docs/photos/IMG_7335.jpeg]
docs/photos/IMG_7335.jpeg
