adi-wayn/animatromic-head/docs/photos/IMG_7302.jpeg

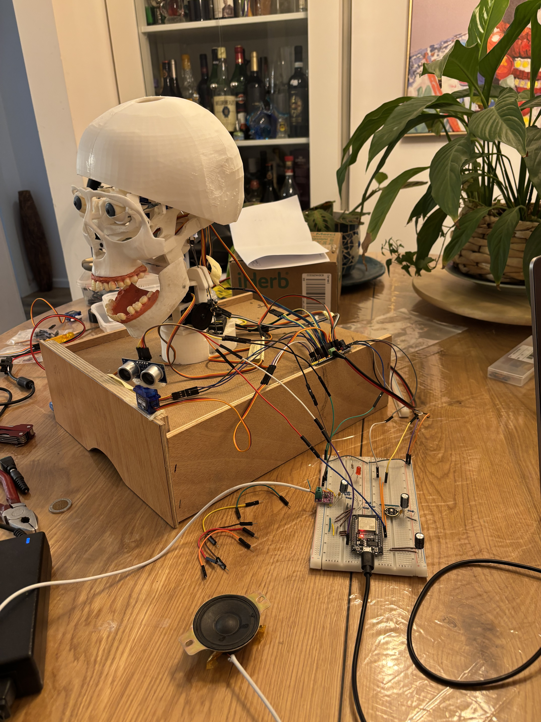
[picture p3: docs/photos/IMG_7302.jpeg]
docs/photos/IMG_7302.jpeg
