adi-wayn/animatromic-head/docs/photos/IMG_7303.jpeg

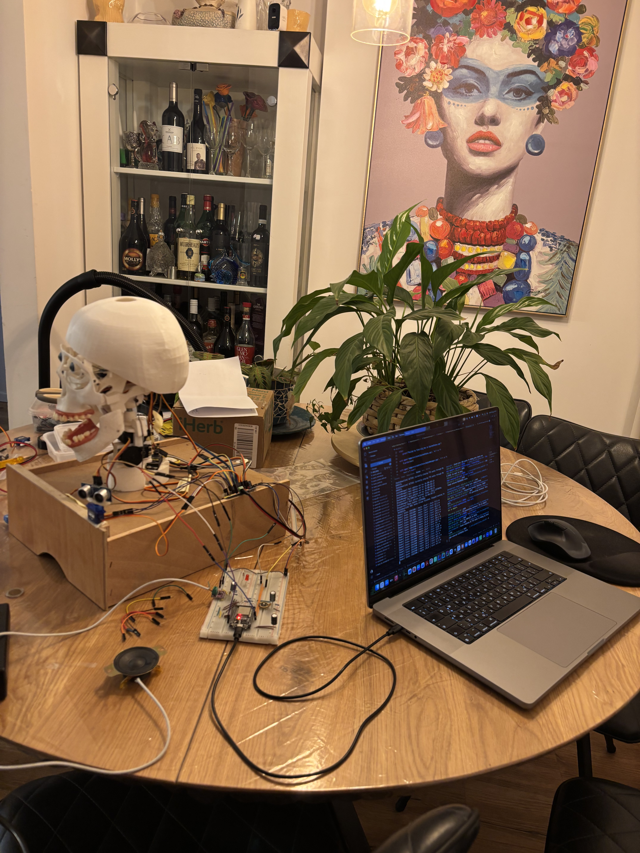
[picture p4: docs/photos/IMG_7303.jpeg]
docs/photos/IMG_7303.jpeg
