adi-wayn/animatromic-head/docs/photos/IMG_7285.jpeg

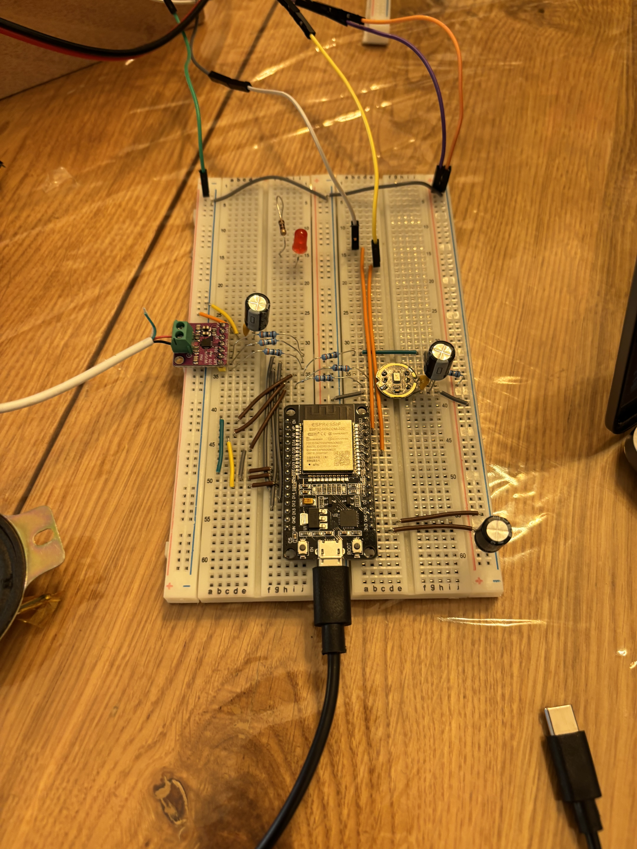
[picture p5: docs/photos/IMG_7285.jpeg]
docs/photos/IMG_7285.jpeg
