adi-wayn/animatromic-head/docs/photos/IMG_7306.jpeg

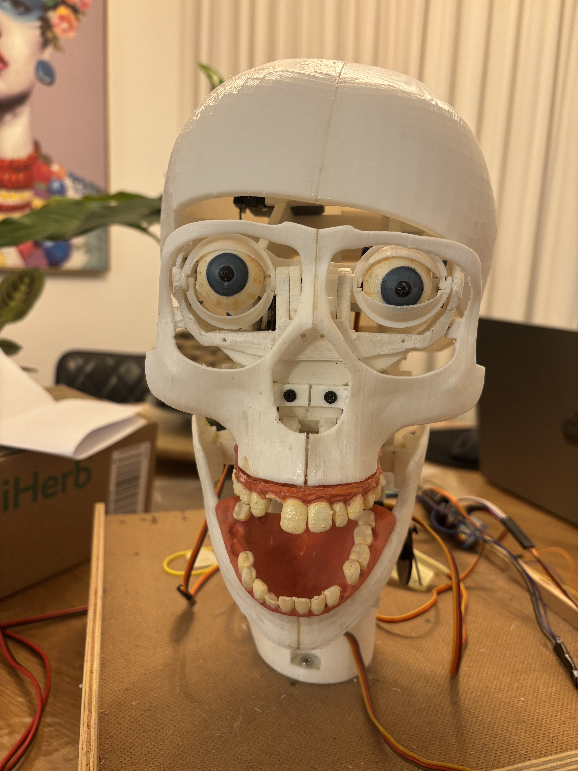
[picture p6: docs/photos/IMG_7306.jpeg]
docs/photos/IMG_7306.jpeg
