adi-wayn/animatromic-head/docs/photos/IMG_7017.jpeg

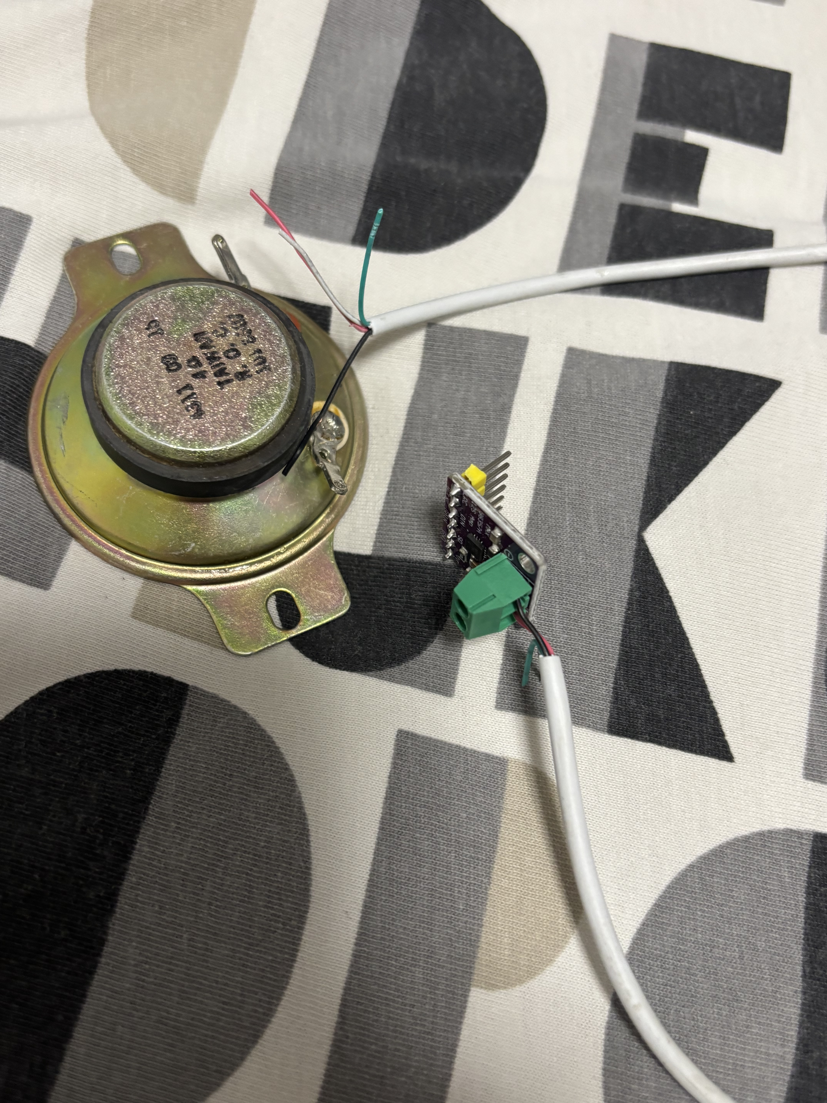
[picture p7: docs/photos/IMG_7017.jpeg]
docs/photos/IMG_7017.jpeg
