adi-wayn/animatromic-head/docs/photos/IMG_6957.jpeg

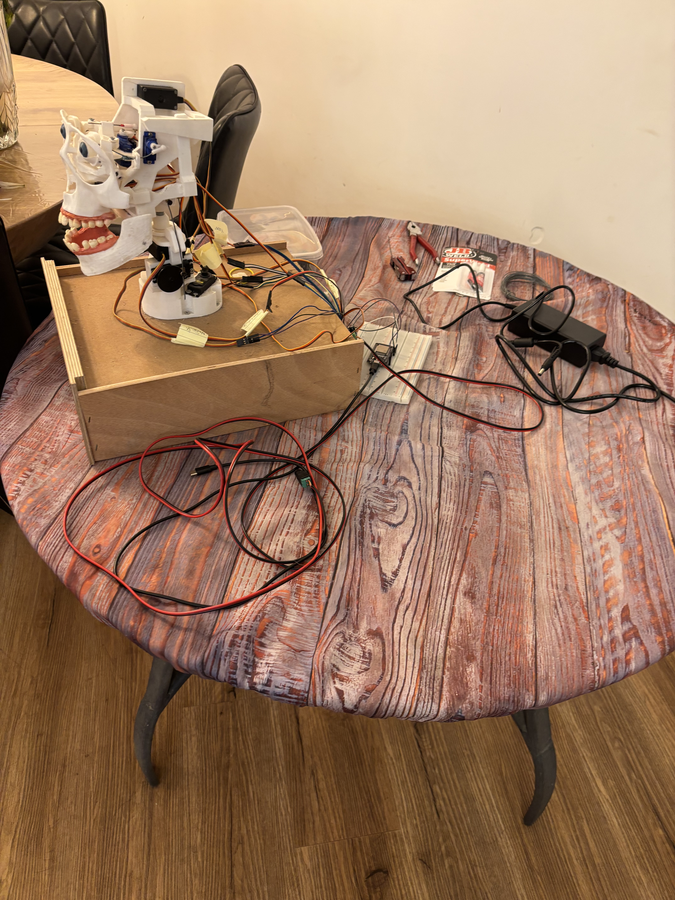
[picture p8: docs/photos/IMG_6957.jpeg]
docs/photos/IMG_6957.jpeg
